lamikr/hrm_breakoutboards/components/3dshapes/SFH_7074.stp

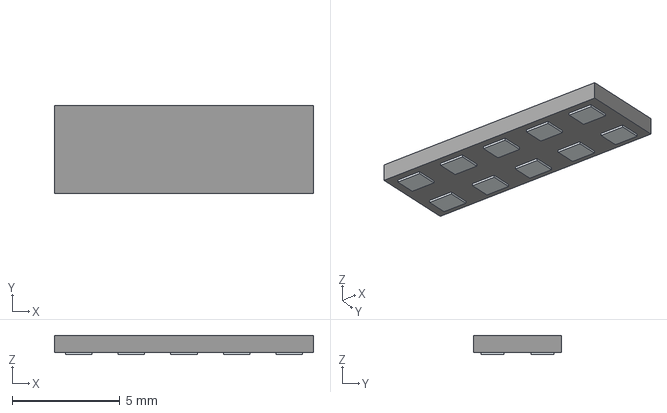
[picture p1: CAD file, 2024-03-02]
components/3dshapes/SFH_7074.stp
12.0 x 4.10 x 0.9 mm
Pins
