lamikr/hrm_breakoutboards/components/3dshapes/SFH_2200.stp

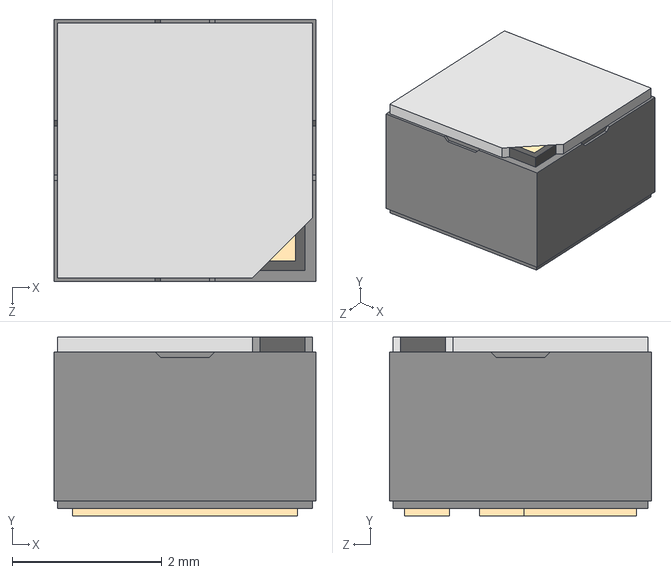
[picture p2: CAD file, 2024-03-02]
components/3dshapes/SFH_2200.stp
3.50 x 2.39 x 3.50 mm
