lamikr/hrm_breakoutboards/components/3dshapes/BGA33_WLCSP33_ADI.stp

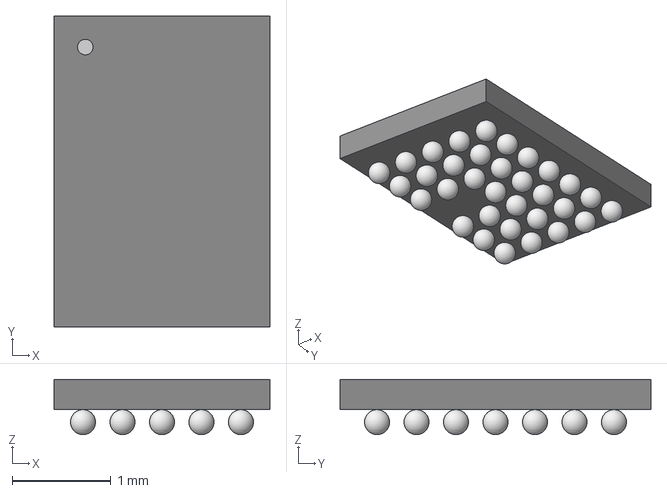
[picture p3: CAD file, 2024-03-01]
components/3dshapes/BGA33_WLCSP33_ADI.stp
2.18 x 3.15 x 0.561 mm
