lamikr/hrm_breakoutboards/components/3dshapes/SFH7072_OSR.stp

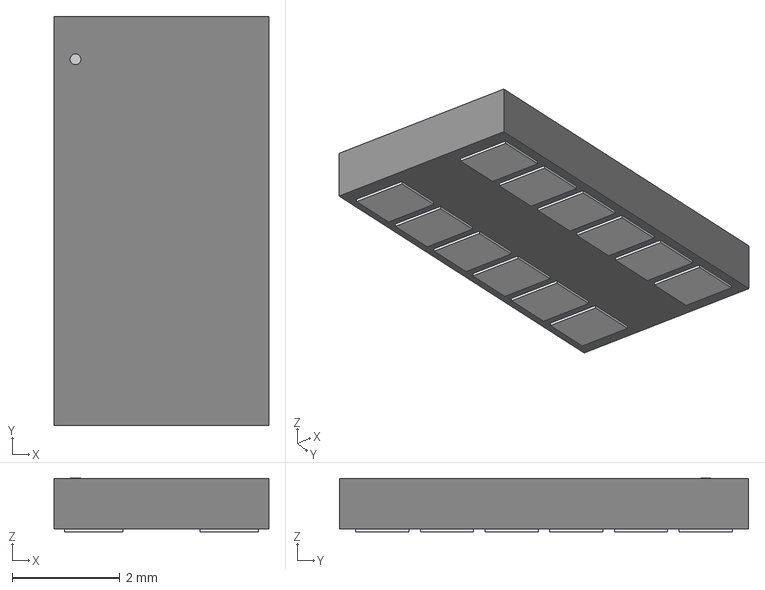
[picture p4: CAD file, 2024-02-27]
components/3dshapes/SFH7072_OSR.stp
3.99 x 7.59 x 0.993 mm
