lamikr/hrm_breakoutboards/components/3dshapes/LD39100PU18RY.stp

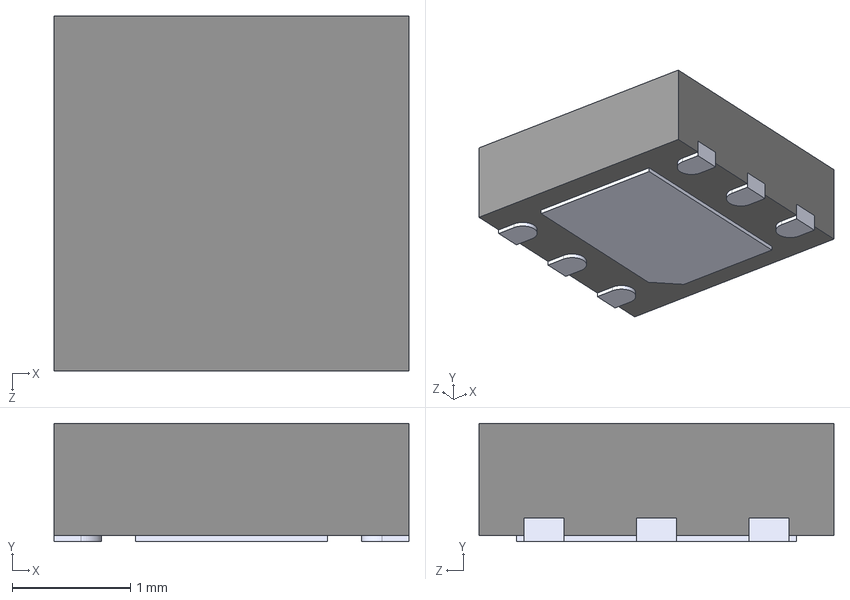
[picture p5: CAD file, 2024-02-27]
components/3dshapes/LD39100PU18RY.stp
3.00 x 1 x 3.00 mm
