lamikr/hrm_breakoutboards/components/3dshapes/LD39115J33R.stp

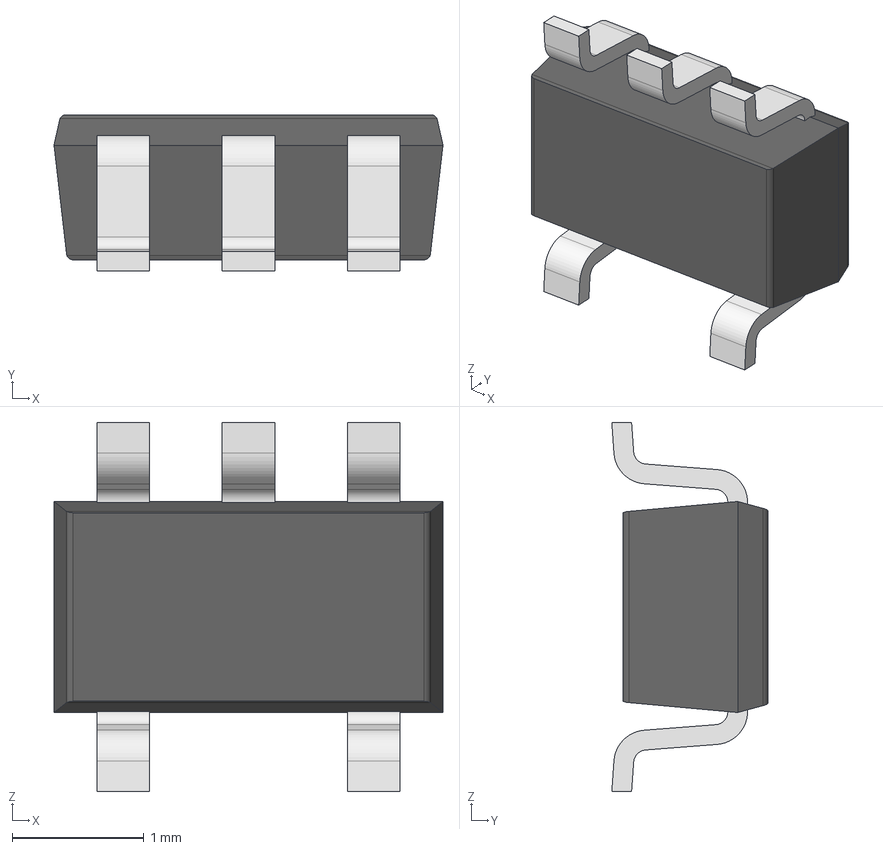
[picture p6: CAD file, 2024-02-27]
components/3dshapes/LD39115J33R.stp
2.95 x 1.19 x 2.80 mm
