lamikr/hrm_breakoutboards/sfh7072_breakoutboard/sfh7072_breakoutboard.kicad_pcb

## KiCad design sfh7072_breakoutboard/sfh7072_breakoutboard.kicad_pcb (2024-03-29)

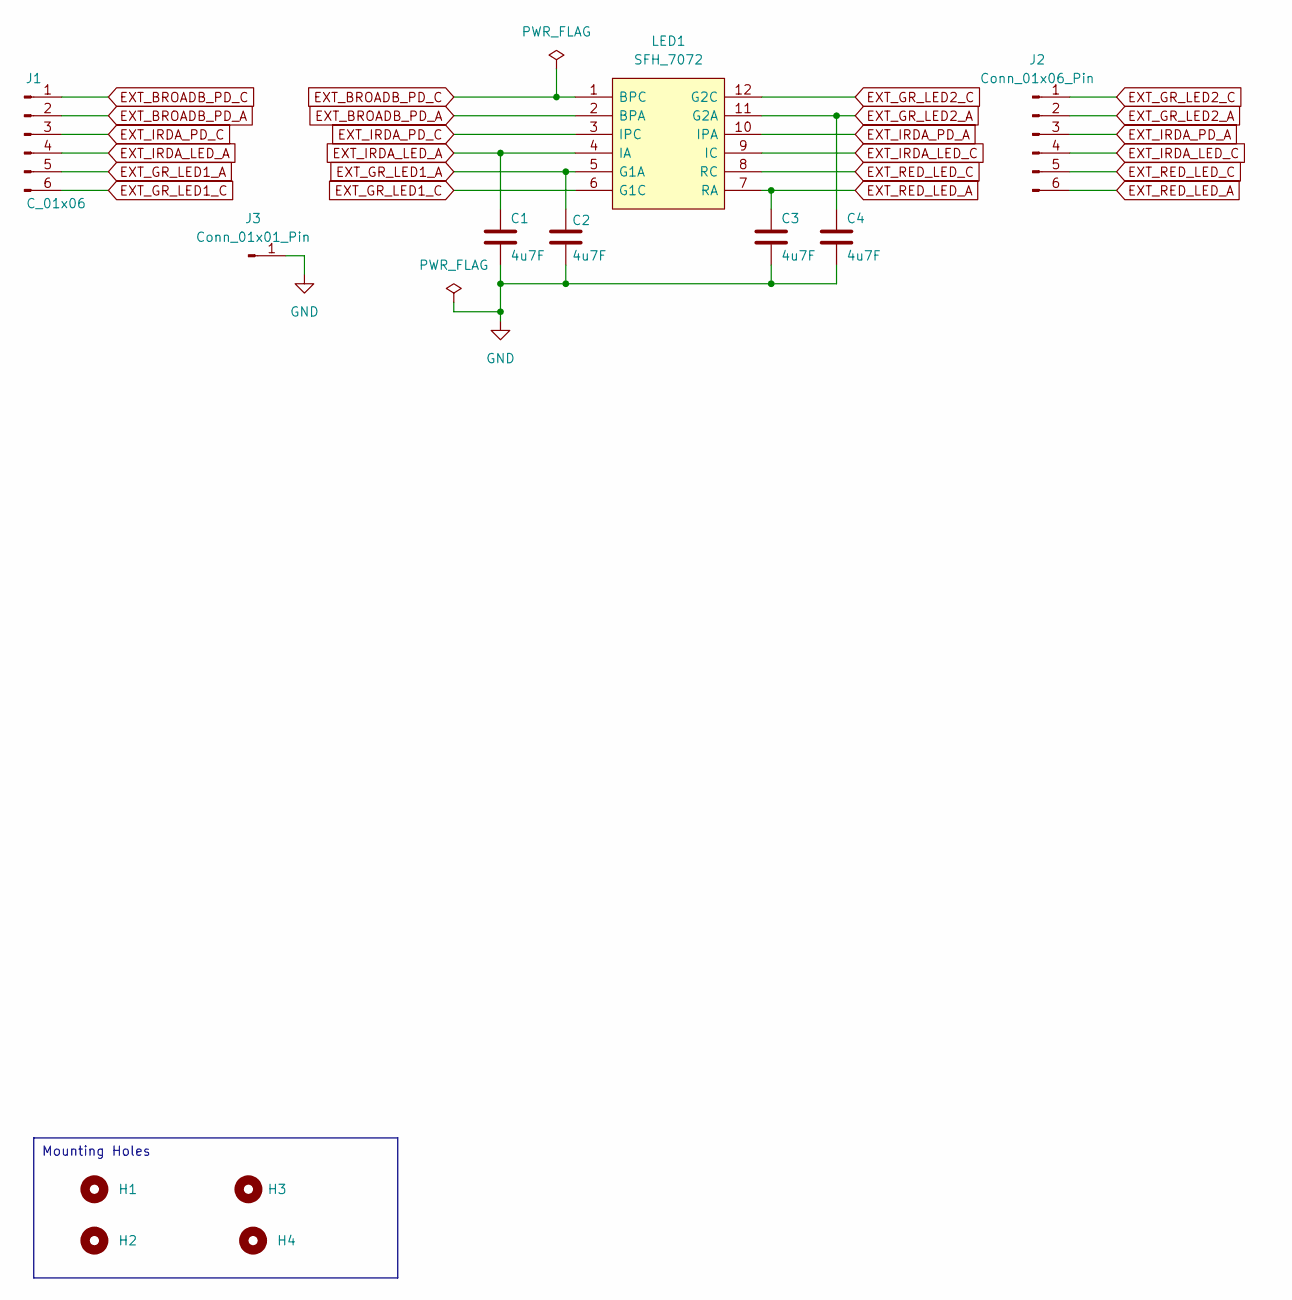
[picture p7: schematic sfh7072_breakoutboard.kicad_sch, SFH7072 Breakoutboard]

Parts:
C1, C2, C3, C4: 4u7F; C_0603_1608Metric
H1, H2, H3, H4: MountingHole; PinHeader_1x01_P1.27mm_Vertical
J1: C_01x06; PinHeader_1x06_P2.54mm_Vertical
J2: Conn_01x06_Pin; PinHeader_1x06_P2.54mm_Vertical
J3: Conn_01x01_Pin; PinHeader_1x01_P1.27mm_Vertical
LED1: SFH_7072; SFH7072; Manufacturer_Part_Number SFH 7072; Mouser Part Number 720-SFH7072

Connections:
EXT_BROADB_PD_A: J1.2, LED1.2 (BPA)
EXT_BROADB_PD_C: J1.1, LED1.1 (BPC)
EXT_GR_LED1_A: C2.1, J1.5, LED1.5 (G1A)
EXT_GR_LED1_C: J1.6, LED1.6 (G1C)
EXT_GR_LED2_A: C4.1, J2.2, LED1.11 (G2A)
EXT_GR_LED2_C: J2.1, LED1.12 (G2C)
EXT_IRDA_LED_A: C1.1, J1.4, LED1.4 (IA)
EXT_IRDA_LED_C: J2.4, LED1.9 (IC)
EXT_IRDA_PD_A: J2.3, LED1.10 (IPA)
EXT_IRDA_PD_C: J1.3, LED1.3 (IPC)
EXT_RED_LED_A: C3.1, J2.6, LED1.7 (RA)
EXT_RED_LED_C: J2.5, LED1.8 (RC)
GND: C1.2, C2.2, C3.2, C4.2, J3.1

Notes on the sheet:
Mounting Holes

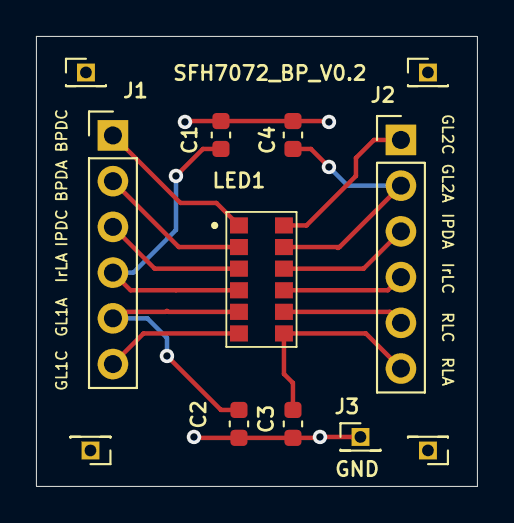
[picture p8: board sfh7072_breakoutboard.kicad_pcb from above]

Board: 2 copper layers, 24.5 x 25.0 mm, 12 parts (0 on the bottom side), 13 nets.
