lamikr/hrm_breakoutboards/adpd1080_breakoutboard/adpd1080_breakoutboard.kicad_pcb

## KiCad design adpd1080_breakoutboard/adpd1080_breakoutboard.kicad_pcb (2024-03-28)

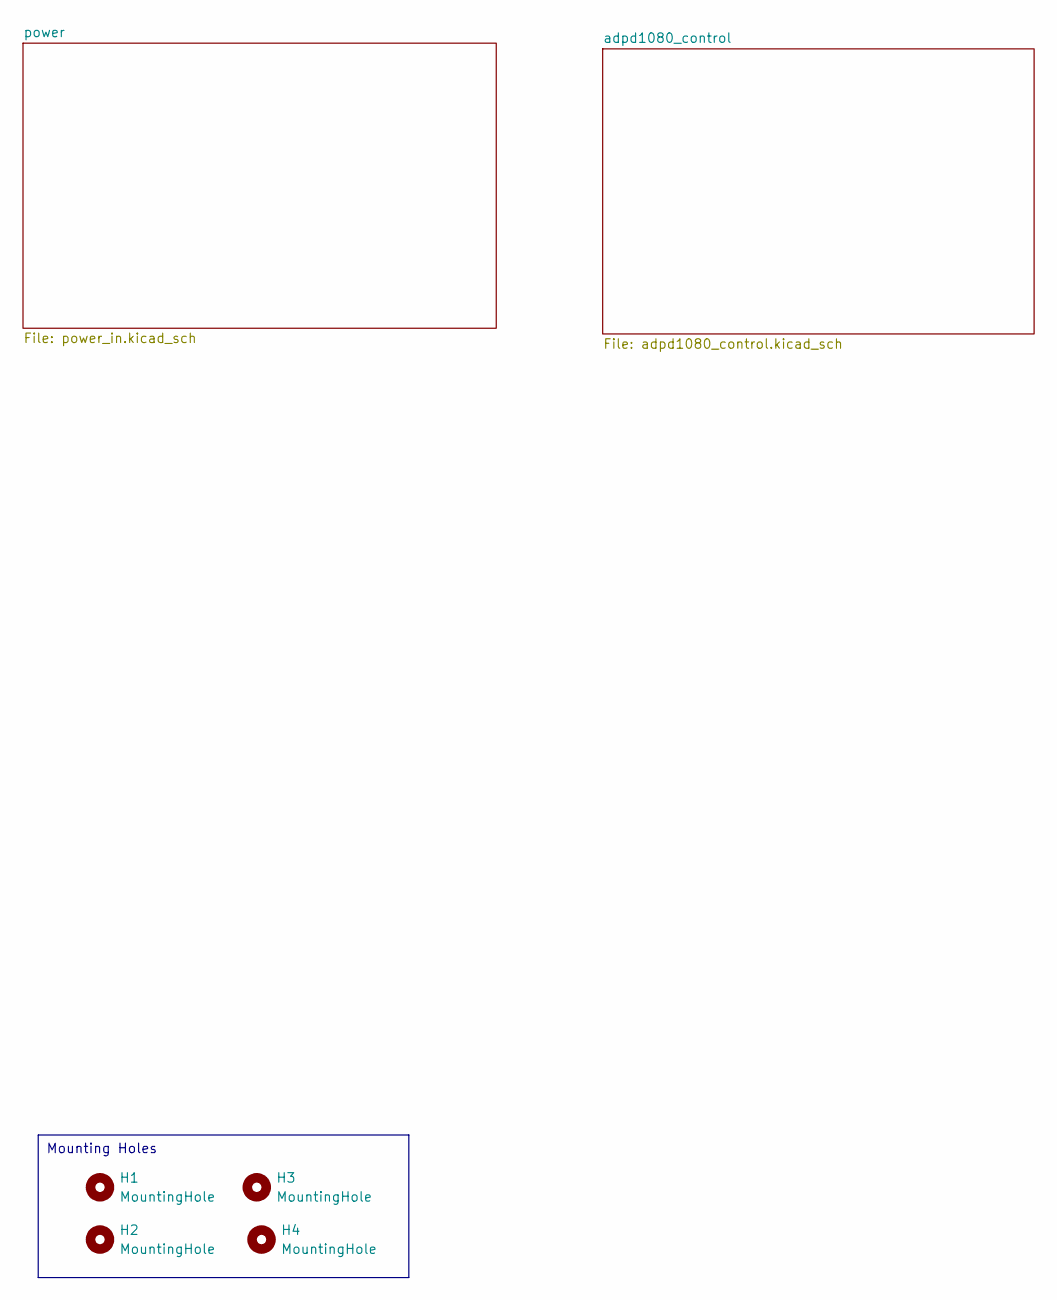
[picture p9: schematic adpd1080_breakoutboard.kicad_sch, ADPD1080 Breakoutboard]

Parts:
H1, H2, H3, H4: MountingHole; PinHeader_1x01_P1.27mm_Vertical

Notes on the sheet:
Mounting Holes

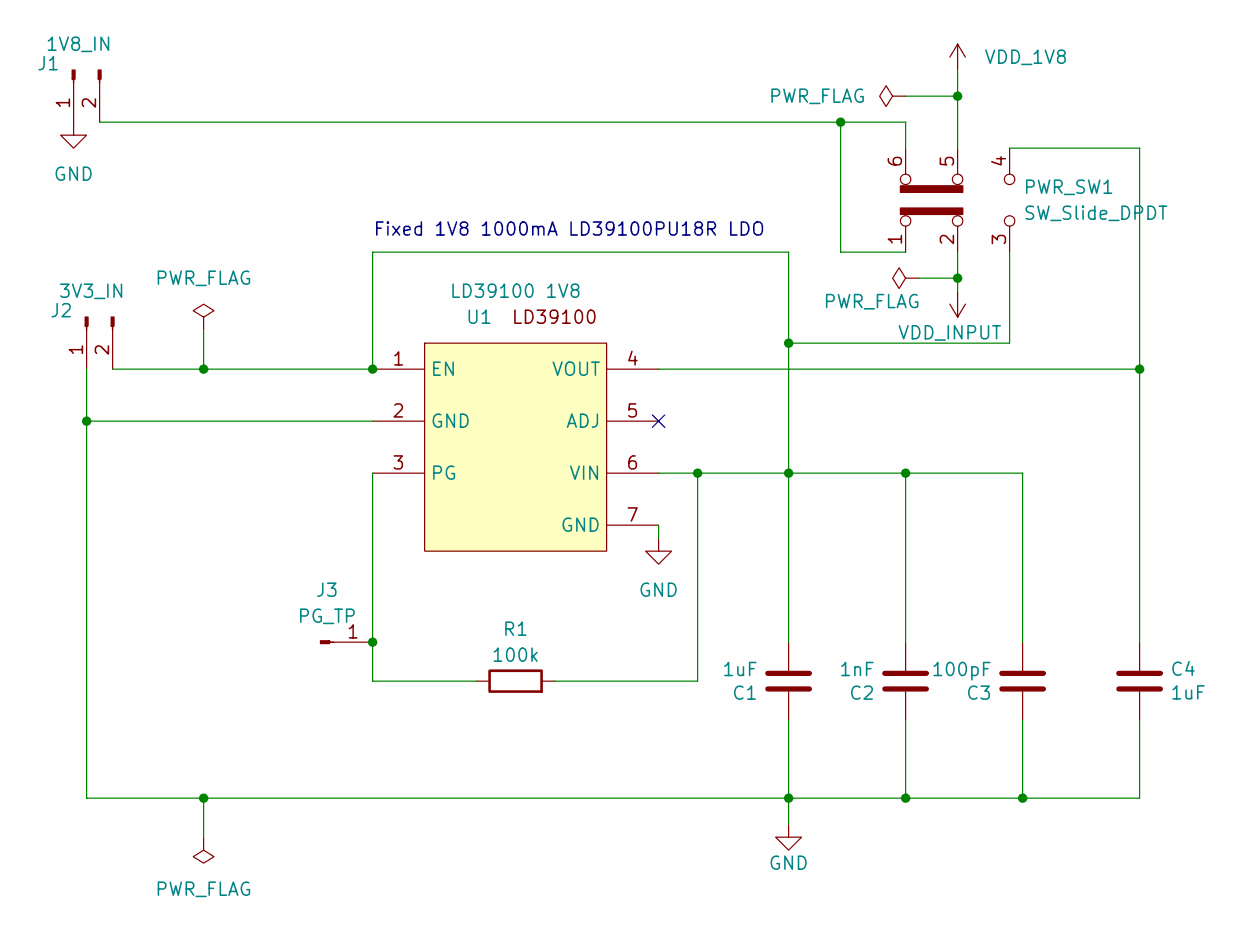
[picture p10: schematic power_in.kicad_sch, ADPD1080 Breakoutboard]

Parts:
C1, C4: 1uF; C_0402_1005Metric; MPN GCM188R71E105KA64D
C2: 1nF; C_0402_1005Metric; MPN GCM188R71E105KA64D
C3: 100pF; C_0402_1005Metric; MPN GCM188R71E105KA64D
J1: 1V8_IN; PinHeader_1x02_P2.54mm_Vertical
J2: 3V3_IN; PinHeader_1x02_P2.54mm_Vertical
J3: PG_TP; PinHeader_1x01_P2.54mm_Vertical
PWR_SW1: SW_Slide_DPDT; SW_CK_JS202011CQN_DPDT_Straight
R1: 100k; R_0402_1005Metric
U1: LD39100 1V8; DFN_00PU33R_STM-L

Connections:
GND: C1.1, C2.1, C3.1, C4.2, J1.1, J2.1, U1.2 (GND), U1.7 (GND); also elsewhere on the board
unnamed: J1.2, PWR_SW1.1 (A), PWR_SW1.6 (C)
unnamed: C1.2, C2.2, C3.2, J2.2, PWR_SW1.3 (C), R1.2, U1.1 (EN), U1.6 (VIN)
unnamed: J3.1, R1.1, U1.3 (PG)
unnamed: C4.1, PWR_SW1.4 (A), U1.4 (VOUT)
VDD_1V8: PWR_SW1.5 (B); also elsewhere on the board
VDD_INPUT: PWR_SW1.2 (B); also elsewhere on the board

Notes on the sheet:
Fixed 1V8 1000mA LD39100PU18R LDO

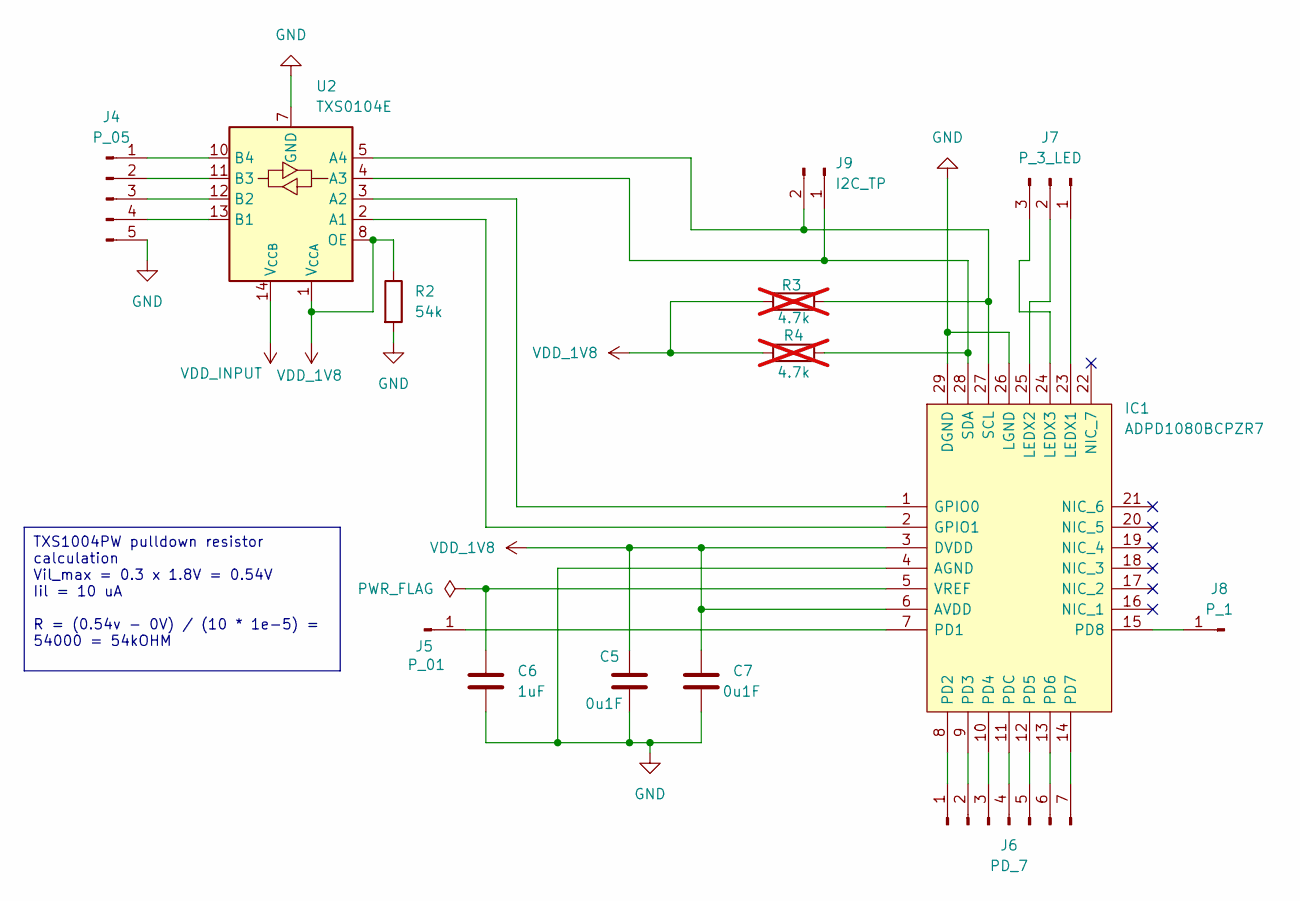
[picture p11: schematic adpd1080_control.kicad_sch, ADPD1080 Breakoutboard]

Parts:
C5, C7: 0u1F; C_0402_1005Metric
C6: 1uF; C_0402_1005Metric
IC1: ADPD1080BCPZR7; QFN40P400X400X80-29N-D; Manufacturer_Part_Number ADPD1080BCPZR7; Mouser Part Number 584-ADPD1080BCPZR7
J4: P_05; PinHeader_1x05_P2.54mm_Vertical
J5: P_01; PinHeader_1x01_P2.54mm_Vertical
J6: PD_7; PinHeader_1x07_P2.54mm_Vertical
J7: P_3_LED; PinHeader_1x03_P2.54mm_Vertical
J8: P_1; PinHeader_1x01_P2.54mm_Vertical
J9: I2C_TP; PinHeader_1x02_P1.27mm_Vertical
R2: 54k; R_0402_1005Metric
R3, R4: 4.7k; R_0402_1005Metric; not fitted
U2: TXS0104E; TSSOP-14_4.4x5mm_P0.65mm

Connections:
GND: C5.2, C6.2, C7.2, IC1.4 (AGND), IC1.26 (LGND), IC1.29 (DGND), J4.5, R2.2, U2.7 (GND); also elsewhere on the board
unnamed: IC1.1 (GPIO0), U2.3 (A2)
unnamed: IC1.2 (GPIO1), U2.2 (A1)
unnamed: IC1.23 (LEDX1), J7.1
unnamed: IC1.25 (LEDX2), J7.2
unnamed: IC1.24 (LEDX3), J7.3
unnamed: IC1.7 (PD1), J5.1
unnamed: IC1.8 (PD2), J6.1
unnamed: IC1.9 (PD3), J6.2
unnamed: IC1.10 (PD4), J6.3
unnamed: IC1.12 (PD5), J6.5
unnamed: IC1.13 (PD6), J6.6
unnamed: IC1.14 (PD7), J6.7
unnamed: IC1.15 (PD8), J8.1
unnamed: IC1.11 (PDC), J6.4
unnamed: IC1.27 (SCL), J9.2, R3.2, U2.5 (A4)
unnamed: IC1.28 (SDA), J9.1, R4.2, U2.4 (A3)
unnamed: C6.1, IC1.5 (VREF)
unnamed: J4.1, U2.10 (B4)
unnamed: J4.2, U2.11 (B3)
unnamed: J4.3, U2.12 (B2)
unnamed: J4.4, U2.13 (B1)
VDD_1V8: C5.1, C7.1, IC1.3 (DVDD), IC1.6 (AVDD), R2.1, R3.1, R4.1, U2.1 (V_{CCA}), U2.8 (OE); also elsewhere on the board
VDD_INPUT: U2.14 (V_{CCB}); also elsewhere on the board

Notes on the sheet:
TXS1004PW pulldown resistor calculation Vil_max = 0.3 x 1.8V = 0.54V Iil = 10 uA R = (0.54v - 0V) / (10 * 1e-5) = 54000 = 54kOHM

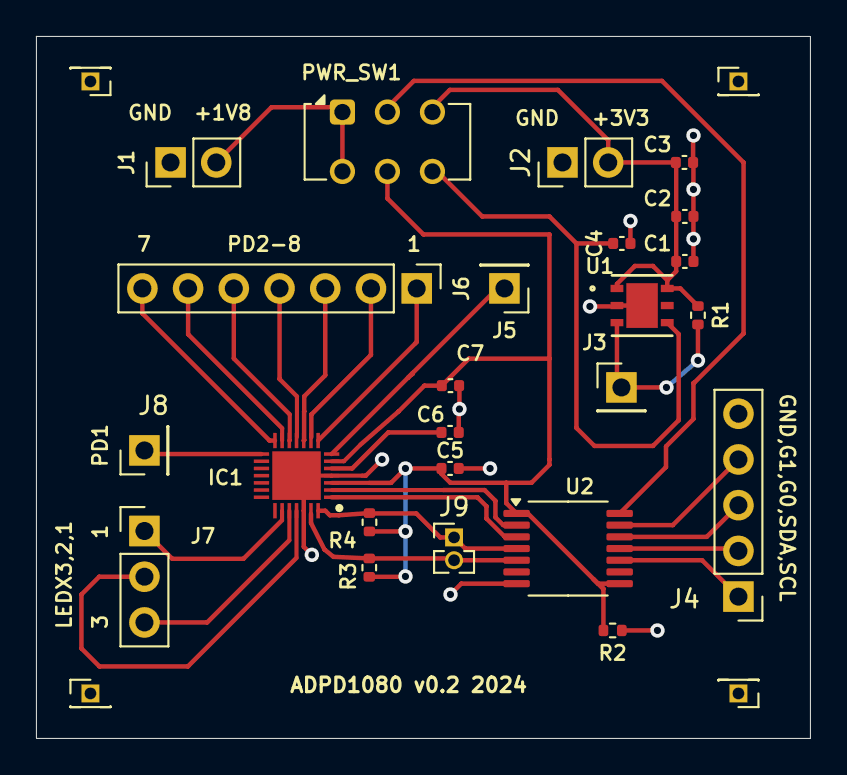
[picture p12: board adpd1080_breakoutboard.kicad_pcb from above]

Board: 2 copper layers, 43.0 x 39.0 mm, 28 parts (0 on the bottom side), 28 nets.
