lamikr/hrm_breakoutboards/sfh7074_breakoutboard/sfh7074_breakoutboard.kicad_pcb

## KiCad design sfh7074_breakoutboard/sfh7074_breakoutboard.kicad_pcb (2024-03-02)

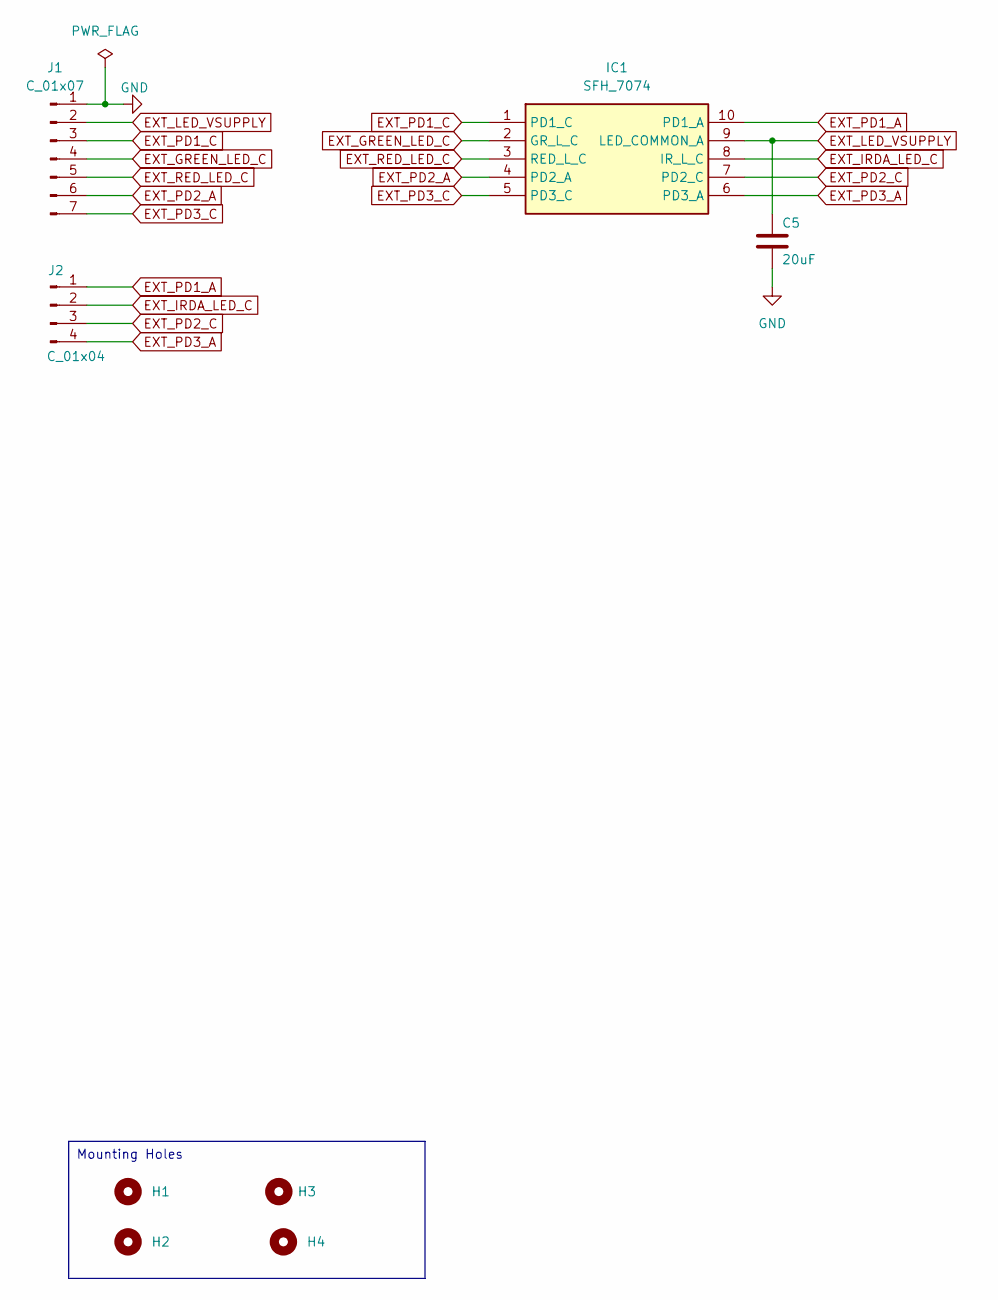
[picture p13: schematic sfh7074_breakoutboard.kicad_sch, SFH7072 Breakoutboard]

Parts:
C5: 20uF; C_0603_1608Metric
H1, H2, H3, H4: MountingHole; PinHeader_1x01_P1.27mm_Vertical
IC1: SFH_7074; SFH7074; Mouser Part Number 720-SFH7074
J1: C_01x07; PinHeader_1x07_P2.54mm_Vertical
J2: C_01x04; PinHeader_1x04_P2.54mm_Vertical

Connections:
EXT_GREEN_LED_C: IC1.2 (GR_L_C), J1.4
EXT_IRDA_LED_C: IC1.8 (IR_L_C), J2.2
EXT_LED_VSUPPLY: C5.1, IC1.9 (LED_COMMON_A), J1.2
EXT_PD1_A: IC1.10 (PD1_A), J2.1
EXT_PD1_C: IC1.1 (PD1_C), J1.3
EXT_PD2_A: IC1.4 (PD2_A), J1.6
EXT_PD2_C: IC1.7 (PD2_C), J2.3
EXT_PD3_A: IC1.6 (PD3_A), J2.4
EXT_PD3_C: IC1.5 (PD3_C), J1.7
EXT_RED_LED_C: IC1.3 (RED_L_C), J1.5
GND: C5.2, J1.1

Notes on the sheet:
Mounting Holes

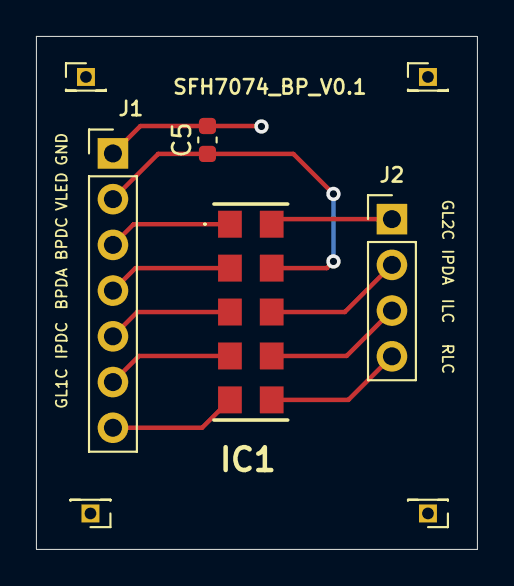
[picture p14: board sfh7074_breakoutboard.kicad_pcb from above]

Board: 2 copper layers, 24.5 x 28.5 mm, 8 parts (0 on the bottom side), 11 nets.
