lamikr/hrm_breakoutboards/sfh7070_breakoutboard/sfh7070_breakoutboard.kicad_pcb

## KiCad design sfh7070_breakoutboard/sfh7070_breakoutboard.kicad_pcb (2024-03-02)

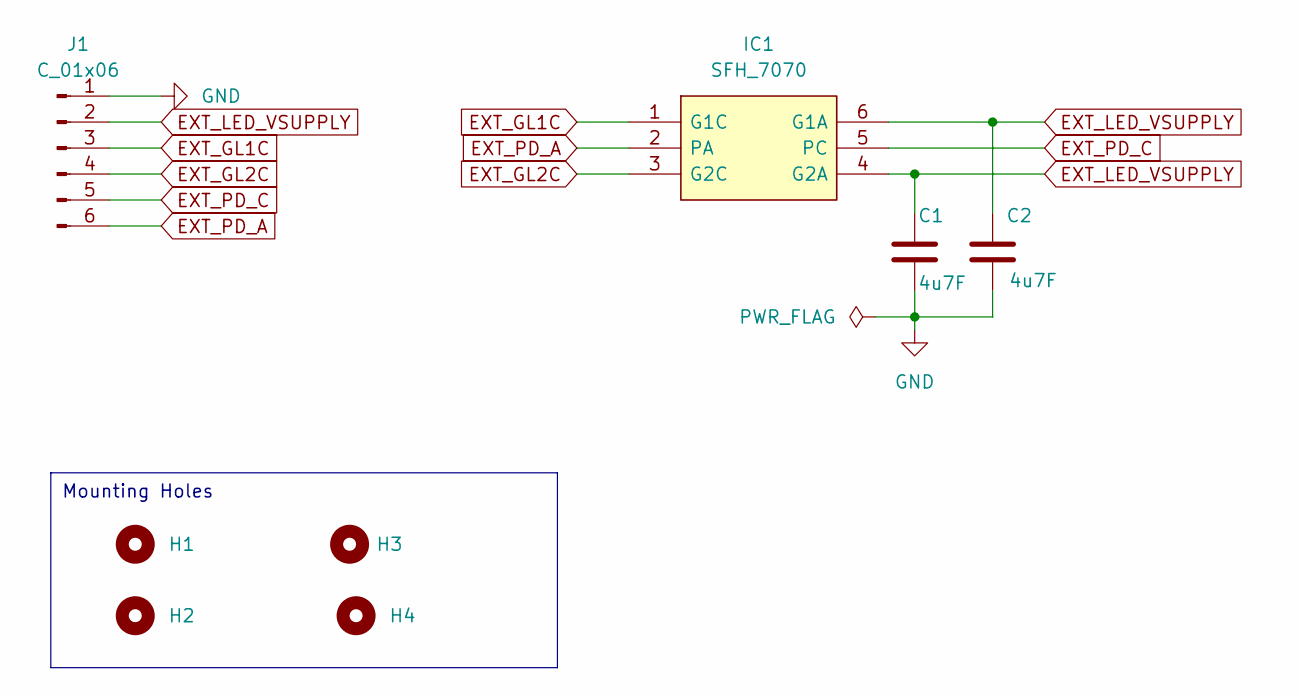
[picture p15: schematic sfh7070_breakoutboard.kicad_sch, SFH7072 Breakoutboard]

Parts:
C1, C2: 4u7F; C_0603_1608Metric
H1, H2, H3, H4: MountingHole; PinHeader_1x01_P1.27mm_Vertical
IC1: SFH_7070; SFH7070; Manufacturer_Part_Number SFH 7070; Mouser Part Number 720-SFH7070
J1: C_01x06; PinHeader_1x06_P2.54mm_Vertical

Connections:
EXT_GL1C: IC1.1 (G1C), J1.3
EXT_GL2C: IC1.3 (G2C), J1.4
EXT_LED_VSUPPLY: C1.1, C2.1, IC1.4 (G2A), IC1.6 (G1A), J1.2
EXT_PD_A: IC1.2 (PA), J1.6
EXT_PD_C: IC1.5 (PC), J1.5
GND: C1.2, C2.2, J1.1

Notes on the sheet:
Mounting Holes

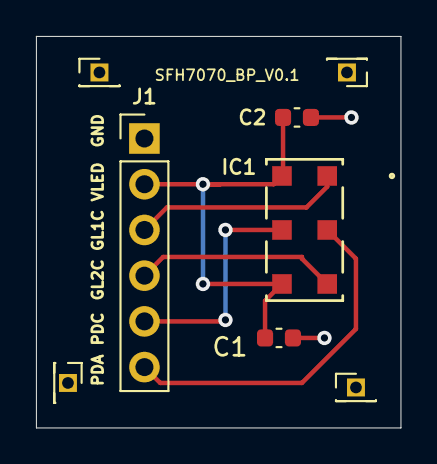
[picture p16: board sfh7070_breakoutboard.kicad_pcb from above]

Board: 2 copper layers, 20.2 x 21.8 mm, 8 parts (0 on the bottom side), 6 nets.
