lamikr/hrm_breakoutboards/(commit log)

2024-02-27 adpd1080 breakoutboard
    [LD39100PU18RY.stp, LD39115J33R.stp, SFH7072_OSR.stp, adpd1080_breakoutboard.kicad_pcb, adpd1080_breakoutboard.kicad_sch, adpd1080_control.kicad_sch, power_in.kicad_sch]
2024-02-28 added sfh7072 breakoutboard
    [sfh7072_breakoutboard.kicad_pcb, sfh7072_breakoutboard.kicad_sch]
2024-03-01 removed caps that were in wrong side of ledx
    [adpd1080_breakoutboard.kicad_pcb, adpd1080_control.kicad_sch]
2024-03-01 adpd4101 symbol and footprint
    [BGA33_WLCSP33_ADI.stp]
2024-03-01 sfh7072 cap location updates
    [sfh7072_breakoutboard.kicad_pcb, sfh7072_breakoutboard.kicad_sch]
2024-03-02 component library updates
    [SFH_2200.stp, SFH_7074.stp]
2024-03-02 adpd1080 pcb manufacturing files
    [adpd1080_breakoutboard-B_Cu.gbr, adpd1080_breakoutboard-B_Mask.gbr, adpd1080_breakoutboard-B_Paste.gbr, adpd1080_breakoutboard-B_Silkscreen.gbr, adpd1080_breakoutboard-Edge_Cuts.gbr, adpd1080_breakoutboard-F_Cu.gbr, adpd1080_breakoutboard-F_Mask.gbr, adpd1080_breakoutboard-F_Paste.gbr]
2024-03-02 sfh7070 breakoutboard and pcb manufacturing
    [sfh7070_breakoutboard-B_Cu.gbr, sfh7070_breakoutboard-B_Mask.gbr, sfh7070_breakoutboard-B_Paste.gbr, sfh7070_breakoutboard-B_Silkscreen.gbr, sfh7070_breakoutboard-Edge_Cuts.gbr, sfh7070_breakoutboard-F_Cu.gbr, sfh7070_breakoutboard-F_Mask.gbr, sfh7070_breakoutboard-F_Paste.gbr]
2024-03-02 sfh7072 breakoutboard and pcb manufacturing
    [sfh7072_breakoutboard-B_Cu.gbr, sfh7072_breakoutboard-B_Mask.gbr, sfh7072_breakoutboard-B_Paste.gbr, sfh7072_breakoutboard-B_Silkscreen.gbr, sfh7072_breakoutboard-Edge_Cuts.gbr, sfh7072_breakoutboard-F_Cu.gbr, sfh7072_breakoutboard-F_Mask.gbr, sfh7072_breakoutboard-F_Paste.gbr]
2024-03-02 sfh7074 breakoutboard and pcb manufacturing
    [sfh7074_breakoutboard-B_Cu.gbr, sfh7074_breakoutboard-B_Mask.gbr, sfh7074_breakoutboard-B_Paste.gbr, sfh7074_breakoutboard-B_Silkscreen.gbr, sfh7074_breakoutboard-Edge_Cuts.gbr, sfh7074_breakoutboard-F_Cu.gbr, sfh7074_breakoutboard-F_Mask.gbr, sfh7074_breakoutboard-F_Paste.gbr]
2024-03-02 sfh7072 soldermask -10pct update
    [sfh7072_breakoutboard-B_Cu.gbr, sfh7072_breakoutboard-B_Mask.gbr, sfh7072_breakoutboard-B_Paste.gbr, sfh7072_breakoutboard-B_Silkscreen.gbr, sfh7072_breakoutboard-Edge_Cuts.gbr, sfh7072_breakoutboard-F_Cu.gbr, sfh7072_breakoutboard-F_Mask.gbr, sfh7072_breakoutboard-F_Paste.gbr]
2024-03-28 added txs0104e symbol
    - add least the tssop package footprint
    and symbol is pin compatible with the txb0104
2024-03-28 replace txb0104 with txs0104e for i2c
    - txb0104 does not work with i2c but txs0104e works
    - changed the i2c pull-ups to 'no-placement' because
    the txs0104e has internal 10k pull-ups
    - added test points for 1v8 logic scl and sda
    [adpd1080_breakoutboard.kicad_pcb, adpd1080_breakoutboard.kicad_sch, adpd1080_control.kicad_sch, power_in.kicad_sch]
2024-03-28 updated bom and gerber files for v0.2 board version
    [adpd1080_breakoutboard-B_Cu.gbr, adpd1080_breakoutboard-B_Mask.gbr, adpd1080_breakoutboard-B_Paste.gbr, adpd1080_breakoutboard-B_Silkscreen.gbr, adpd1080_breakoutboard-Edge_Cuts.gbr, adpd1080_breakoutboard-F_Cu.gbr, adpd1080_breakoutboard-F_Mask.gbr, adpd1080_breakoutboard-F_Paste.gbr]
2024-03-29 sfh7072 board with separate anode for all leds
    - separate anode and cathode connector for all leds
    and photodiodes
    [sfh7072_breakoutboard-B_Cu.gbr, sfh7072_breakoutboard-B_Mask.gbr, sfh7072_breakoutboard-B_Paste.gbr, sfh7072_breakoutboard-B_Silkscreen.gbr, sfh7072_breakoutboard-Edge_Cuts.gbr, sfh7072_breakoutboard-F_Cu.gbr, sfh7072_breakoutboard-F_Mask.gbr, sfh7072_breakoutboard-F_Paste.gbr]
