lamikr/hrm_breakoutboards/(notices)

Notices in the files:
adpd1080_breakoutboard/adpd1080_breakoutboard.kicad_sch:
Copyright (C) 2024, Mika Laitio
